AT2032/2025torikon/README.md

# 2025鳥コンの電装資料
## 組み立て
### 琵琶湖に行く前
- コクピに取り付け済みの部品
  - [コクピ事前準備(トラック積み込み前).md](https://github.com/AT2032/2025torikon/blob/main/%E3%82%B3%E3%82%AF%E3%83%94%E4%BA%8B%E5%89%8D%E6%BA%96%E5%82%99(%E3%83%88%E3%83%A9%E3%83%83%E3%82%AF%E7%A9%8D%E3%81%BF%E8%BE%BC%E3%81%BF%E5%89%8D).md#%E3%82%B3%E3%82%AF%E3%83%94%E4%BA%8B%E5%89%8D%E6%BA%96%E5%82%99)
- 他の準備
 - トランシーバー充電
 - リポ充電
### 琵琶湖ついてから
- 電装の検品・バッテリー準備
