AT2032/2025torikon/25代電装全体図.md

# 基本設計
## 全体像


## 物理的な配置
