AT2032/2025torikon/準備＆組み立て手順.md

# 琵琶湖に行く前
## コクピに取り付け済みの部品
  - [コクピ事前準備(トラック積み込み前)](https://github.com/AT2032/2025torikon/blob/main/%E3%82%B3%E3%82%AF%E3%83%94%E4%BA%8B%E5%89%8D%E6%BA%96%E5%82%99(%E3%83%88%E3%83%A9%E3%83%83%E3%82%AF%E7%A9%8D%E3%81%BF%E8%BE%BC%E3%81%BF%E5%89%8D).md#%E3%82%B3%E3%82%AF%E3%83%94%E4%BA%8B%E5%89%8D%E6%BA%96%E5%82%99)
##  他の準備
 - トランシーバー充電
 - [動作確認](https://github.com/AT2032/2025torikon/blob/main/%E5%8B%95%E4%BD%9C%E7%A2%BA%E8%AA%8D.md)
 - リポ充電
 - 電装BOXと持ち物(個人で持っていくものの確認)  
[電装持ち物リスト](https://tusedu-my.sharepoint.com/:x:/g/personal/8223036_ed_tus_ac_jp/EaBhuFKCY5RGtiFWbql846QBNDzBeOHudqavIxN8KoX_pQ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)
# 琵琶湖ついてから
## 電装の検品・バッテリー準備
- ゆるみの確認
 - メイン電装の固定ネジ確認
 - アンテナのゆるみ確認
 - メインSD
- ピトー管のベーン取り付け
- バッテリー搭載
  - バッテリーの電圧をテスター測定し，12.5V以上であることを確認する
  - バッテリーのコネクタを接続し，タッパーに入れる

組み立て手順(コクピ班のもの)


## ピトー管接合
- フレームとT字を接合したい状態でピトー管をフレームにつける(位置はフレームにマステを貼ってある)


- ピトー管をつけた後は安全保護用に発泡を下につける(白養生で止める)


## 電装基盤の取り付け
- かまぼこをフレームに取り付け，その後電装基盤の板を入れる
- 基盤を入れたらケーブルのコネクタを取り付ける


- [動作確認](https://github.com/AT2032/2025torikon/blob/main/%E5%8B%95%E4%BD%9C%E7%A2%BA%E8%AA%8D.md)
(超音波とピトー管，サーボを取り付けて正常に動作するかを確認する)

## サーボのケーブル
- カウルを取り付けた後に，カウルの穴にケーブルを差し込んでカウルの中にケーブルを入れる(ケーブルは白養生で固定する)



- カウル内部のケーブルはT字やカウルに養生テープで固定する



## 機体下電装
- カウルをつける前にカウルに機体下電装の基盤とケーブルを養生テープで固定する(固定する際，超音波センサーができる限り地面と水平と平行になるように固定する)

- カウルをつける際に，ケーブルの接続とテグスをフレームにつける

## ピトー管先端取り付け
- 上2のカウルが取り付け終わった段階でピトー管の先端のケーブルを接続し，取り付ける


## 電装安全確認
- 操縦桿周りの安全確認
- ピトー管の固定具周りの安全確認
- スピーカーの安全確認
- ケーブルの安全確認(ケーブルがぶらーんとしてなければOK)

## AoAとAoSの定常状態の確認
- カウルとキャノピーを取り付けた後で電源を入れ，AoAとAoSの定常状態を確認する(水平は目視で揃える)
