AT2032/2025torikon/プラホ.md

# プラホ上での電装の仕事(けんの＋くり)
# 持ち物(絶対に忘れない)
- テレメトリ
- テレメトリ用CtoC
- アンドロイドスマホ(充電がなければ他の人のを借りる)
- ピトー管フィレット前後1個ずつ
- カッター
- クリアテープ
## 役割(けんの)
- テレメトリでの各種動作確認
- 操縦桿と垂直の動きを見る(ニュートラル確認＋左右の垂直の動き(くらのすけが操作))
  - ニュートラル調整後にニュートラルの値を確認してスマホに記録する(スクショでもいい)
  
## 役割(くり) → プラホあがるときにピトー管のフィレットを持っていく
- ピトー管フィレットをつける(水町さん+くり) → 左右のフィレットのつなぎ目の部分をクリテで止める


- メインの電源を入れる
  - メインの電源を入れた段階でストップウォッチをスタートし，TAKEOFFの時点でラップをつけ，着水時にストップウォッチを止める(ログの解析のため)
  
    
- 垂直のニュートラル位置調整
- メインのLEDがすべてついているか確認
- ピトー管カバー取り外し
## スケージュール
  

## 抜けるタイミング
- 同じタイミングで抜ける(ラダーの左右の動きを見てから)
- けんのからテレメトリを受け取る
