AT2032/2025torikon/エアデータ製作/ハードウェア/回路・基板製作/回路・基板設計.md

## 回路設計(回路図ファイルはこちら)
<p align="center">
　
  <em>エアデータ回路図</em>
  <br>
</p>

- SD書き込み関しては時間がかかるため，一番通信速度の速いSPI通信([SDのピン配置](https://ht-deko.com/arduino/micro_sdcard.html))
  
- センサとマイコンはI2C通信
  
- マイコンとメインマイコンはUART
  - RRXT → Raspberry pi pico RX - XIAO RP2040 TX
    
  - RTXR → Raspberry pi pico TX - XIAO RP2040 RX
 
- センサとSDの電源入力はマイコンの3.3V出力のピンとつなげる

- マイコンには電源(外部)から5Vを供給する

- I2Cに関してはAS5600が2個使う+AS5600がI2Cアドレスの変更ができないため，チャンネルを2つ使う

- 今回はAS5600(AoA用)とpitotube(差圧センサ)にチャンネル1を使い，それ以外はチャンネル0を用いた  
  (AoAとAoSのセンサでチャンネルが分けられれば他はどのチャンネルに割り当てても変わらない)
  
<p align="center">
 
</p>

- XIAO RP2040のピン配置は上の画像(本来は[こっち](https://wiki.seeedstudio.com/ja/XIAO-RP2040/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)のピン配置が正しいがこのピン配置でも動作することが分かった)

  - 注意点はあるので[このサイト](https://tamanegi-digick.com/it/xiao2040rp/)を読んでおく

## 基板設計(基板図のファイルはこちら)
<p align="center">
 
  <em>エアデータPCB画像</em>
</p>

- 基盤の縦の長さはセンサを全て配置でき，センサの基盤が外に飛び出さない最小の長さにした。

- 基盤の左右にコネクタを配置
  - 片方は基板に配置できない差圧センサとの接続用(I2C)
    
  - もう片方はメイン基板との接続用(UART)
 
- 基盤の長さをできるだけ短くしたかったのでSDカードスロットに関しては基板の裏面に配置
  
  - 実装の際にはんだ付けできるようにSDカードスロットのピン配置と他のセンサの位置を重ならないように少しずらした

- 基盤には固定具取り付け用のねじ穴を計5個配置する

- AoAのセンサを基板に足して横向き(垂直方向)に取り付ける形状，基板の形は写真のようないびつな形になった。

<p align="center">
  
</p>

- もともとは上の写真(あざみ野)のようにエアデータセンサの基盤とAoAとAoSの基盤を分けて作るつもりだったが以下のような問題点があった
  - 基盤を分けて作るのはめんどくさい(部品が多くなるのは嫌だ)
 
  - パイプ内に基盤を固定する必要があり，固定するものが増えると固定具の作製の難易度が上昇する
 
  - 基盤をパイプに入れるとき，CFRPのパイプであるため基板を押し込む必要があり，この形状ではそれが厳しい(取り出したり，メンテナンスができない可能性がある)

- 平面の基板に垂直ピンや垂直取り付け台によってセンサを横向きに取り付けることできる

  - 上記の問題点を解消できる
 
- 基板設計を行いセンサの位置を決めた段階でパイプの形状や固定具の設計も決まる(後述)

## 基板実装
<p align="center">
  
  <br>
  <em>エアデータ基板3Dモデル(表面)</em>
</p>

<p align="center">
  
  <br>
  <em>エアデータ基板3Dモデル(裏面)</em>
</p>

- 基板のセンサ配置にセンサを配置し，はんだ付け

  - 基板の向きに気を付ける(特にBNO055)
 
  - SDカードスロットは裏側に取り付ける(最後に取り付け)
 
<p align="center">
  
  <br>
  <em>エアデータ基板完成図</em>
</p>
