AT2032/2025torikon/要件・全体要求.md

# 要求
要求は上から順に優先。フライトデータの取得よりも飛ぶことが優先
- システムの要求
  1. パイロットの操作でラダーを制御する
  2. プラットホーム上で姿勢の確認
  3. パイロットに速度と対地高度を伝達する
  4. フライトデータを取得する
- 電装班運営の要求
  - 必要な技術を継承する  
# 要件
- 信頼性
  - 故障した際に優先度が低いものが高いものに影響を与えない
    - 無線通信が混信しても他に影響を与えない
    - メイン電装のマイコンが停止しても操舵系は機能を維持する
    - SDカードが脱落しても他の機能は動作する
  - ソフトウェアのバグ，コクピフレームとの接触による短絡，通信線の切断などの故障を想定する
- 安全性
    - 着水時に発煙・発火しない
    - パイロットの頭部付近に電装を配置しない(配置する場合は安全対策をしっかり考える)
- 稼働時間
  - 着水までバッテリーが持つ(バッテリーに最後にアクセスできるタイミングを考えておく)
  - 電圧の監視が可能である
- 環境
  - 機体が直射日光にあたり温度が上昇しても動作する
  - 多少の水滴では故障せず動作し続ける
  - 直射日光下でLEDを見る必要がなく運用できる
  - トラックで輸送する場合，振動や熱に耐えられる
  - 機体の金属やCFRPの粉，琵琶湖の砂の対策がされている
- 運用
  - プラホ上での電装作業を最小限にする
- 開発環境・メンテナンス
  - 琵琶湖で機体を組んだ状態で電装のプログラムを変更できる
  - デバッグに必要な情報をなるべく多く出力する
