AT2032/2025torikon/あ.md

# 要件・要求定義
# 全体像
# エアデータ製作
## ハードウェア
### 回路基板設計
### ケーブル
### 外殻
### 内部固定具
### ベーン
## ソフトウェア
# ラダー制御脊索
## ハードウェア
### 回路基板設計
### ケーブル
### サーボ
## ソフトウェア
# 機体下電装製作
## ハードウェア
### 回路基板設計
### ケーブル
## ソフトウェア
# メイン電装製作
## ハードウェア
### 回路基板設計
### ケーブル
## ソフトウェア
# 班長業務
# 無線機製作
## ハードウェア
## ソフトウェア
# ログの見方(解析方法)
# 電装勉強法
# 鳥コンの動き
# 予算関係
