AT2032/2025torikon/25代製作資料.md

# 2025　電装班
(もっと早くに書いておくべきだった)  
書き方は23代のブログの構成のパクリ → [偉大な先輩のブログ(23代製作資料)](https://771-8bit.com/blog/birdman-glider-avionics/)
# 要求定義
要求は上から順に優先。フライトデータの取得よりも飛ぶことが優先
- システムの要求
  1. パイロットの操作でラダーを制御する
  2. プラットホーム上で姿勢の確認
  3. パイロットに速度と対地高度を伝達する
  4. フライトデータを取得する
- 電装班運営の要求
  1．必要な技術を継承する
# 要件定義
## 共通事項
### 非機能要件
- 信頼性
  - 故障による直接的な機能の喪失は認めるが，優先度が低いものの故障が高いものに影響を与えないような設計にする
    
    - 無線通信が混信しても他に影響を与えない
    - メイン電装のマイコンが停止しても操舵系は機能を維持する
    - SDカードが脱落しても他の機能は動作する
  - ソフトウェアのバグ，コクピフレームとの接触による短絡，通信線の切断などの故障を想定する
  - システムが複雑になるため基本的に冗長は組まず，予備部品の容易で対応する
- 安全性
  - 着水時に発煙・発火しない
  - パイロットの頭部付近(特にキャノピーより前)に電装を配置しない
- 稼働時間
  - 着水までバッテリーが持つ
    - 電圧の監視が可能である
    - バッテリーに最後にアクセスできるのは移動前(ハッチがある場合はこれ，ない場合はバッテリーに最後にアクセスできるのはフライト前日の機体組み立て開始時)
- 環境
  - 機体が直射日光にあたり温度が上昇しても動作する
  - 多少の水滴では故障せず動作し続ける
  - 直射日光下でLEDを見る必要がなく運用できる
  - トラックで輸送する場合，振動や熱に耐えられる
  - 機体の金属やCFRPの粉，琵琶湖の砂の対策がされている
- 運用
  - プラットフォーム上で電装の電源を起動できる
  - プラホ上での電装作業を最小限にする
- 開発環境・メンテナンス
  - 琵琶湖で機体を組んだ状態で電装のプログラムを変更できる
  - デバッグに必要な情報をなるべく多く出力する
- 拡張性
  -　とりあえずなし？
### 制約条件
- 電気的制約
  - SPIとI2Cは通信速度が速く，通信距離が短いため，基板内のみで使用
  - 基板間の通信はUARTでおこなう
  - マイコンの動作電圧は多くのセンサーに合わせて基本3.3V
- 技術的制約
  - Arduino IDEを使用し，自力でライブラリを書かなくてよい構成とする(できる限り)(ライブラリを作る場合は使い方を明記しておく)
  - CANはなるべく使用せず，UARTによる文字列送受信を行う
  - チップ部品は使用しない
  - ケーブルの圧着は基本せず，既製品を使用する
## 操舵
そもそもワイヤーリンケージかフライバイワイヤーかはチームにノウハウがあるかで決めていいと思う
鳥科では代々使われてノウハウがあるフライバイワイヤーを用いる

- パイロットの操作でラダーを制御する
  - 入力を読む
    - 去年まではジョイスティックを用いていたが，ジョイスティックではパイロットが体重移動しながらのラダー操作が難しい上に，直感的な操作がしにくいため，
    - アナログ入力を読むため，回転しやすい可変抵抗を取り付け，レバーの引き具合でラダーを制御できるようにする
    - 不感帯を含む，任意のカーブを設定できる
  - サーボモータを動かす
    - 十分なトルクがある
      - 風対策(逆電流防止)
    - 信号・電力の減衰が起きない
      - ケーブルが断線しない
      - ケーブルの電圧降下が小さい
      - テールまでの長いケーブルで問題なく信号伝達ができる
- その他の要件
  - トラブル時ニュートラルでフライトできる(これは機構側で担保 → ニュートラルロック)
  - プログラムを変更せずに琵琶湖でニュートラル調整が可能である(操舵範囲は事前調整)
  - テールを軽くする
    - バッテリーはコクピに搭載
    - 軽量なサーボを使用
  - 機体内通信を含む，無線通信で操舵を行ってはならない(大会ルール)
## テレメトリ
- プラホから発進時に姿勢などを確認できるようにする
  - 受信機はポケットに入る程度のサイズにする
    - PC・タブレットは大きくてプラットほーおむで扱いづらい(特に雨天時)
- デバッグのため，全センサーデータをダウンリンクする
## 高度速度計
パイロットからは高度や速度は分かりにくいため，測定したデータを何らかの手段を用いてパイロットに伝える必要がある
- パイロットに対地高度・対気速度を伝達する
  - 対地高度を推定する
    - 測定精度は0.1m単位を要求
    - 技術的な制約
      - 高高度では気圧高度を，低高度では超音波高度を信用すべき
        - 気圧高度は湖面からの絶対高度は分からない
        - 超音波は(ほとんどのセンサーで)高高度からでは届かない → 最近は最大測定距離が8mのものもあるけど，精度が怪しかったり，測定周期が遅かったりする
      - 気圧センサ
        - 動圧・ハッチの衝撃によるセンサーの外れ値を弾く
        - 中央値を取るために違う場所に3つの気圧センサを配置する
      - 超音波センサ
        - 水面付近は気圧高度より信用できる
  - 対気速度を測定する
    - 記録方法は後述
  - パイロットに情報を伝達する
    - 視覚は前方に集中するのでモニター等は使えない
    - 触角は操縦に影響するので使えない
    - 使えるのは聴覚のみ
  - その他の要件
    - フェールセーフ
      - センサーデータが取得できない場合，異常だと検知した場合は読み上げを行わない(ソフト側)
## ロガー
- 下記のデータを記録する

| 優先度 | 測定値 | 備考 |  
|---|---|---|
| 高 | GPS |  ある程度信頼できるため冗長の必要はない  |  
| 高 | 超音波高度 |  超音波が干渉するため1つだけ搭載する  |  
| 高 | 気圧高度 |  高度計の信頼性を確保できる分だけ搭載する  |  
| 高 | 対気速度 |  ピトー管を機体の気流に影響されない位置に取り付ける  |  
| 中 | ラダー操作量 |  ラダー操作に影響を与えないように  |  
| 中 | 9軸・姿勢 |  機体の向きとが正しく分かるようにぐらつかないしっかりした場所に載せる  |  
| 低 | AoA(Angle of Attack)・迎え角 |  ピッチ測定で十分だが，精度をこだわる場合は必要  |  
| 低 | AoS(Angle of Slip)・滑り角 |  代替手段がなく，AoAと同じく製作が高難度  |
- データを同期した状態で記録する
- 着水時にデータをロストしない
- 大型のかっくきで急速な動きをしないことを念頭に置いてデータレートを決定する
  - データレートは大体10~20Hz程度であれば大丈夫
  - 要求に完全に合わせるよりもマイコンのスペックで実現可能なものを実装する流れになるので定量的な要求は出さない
# スケジュール
- BBM：ブレッドボードモデル，試作
- EM：エンジニアモデル(プロトタイプ)
- FM：フライトモデル，本番用
# 基本設計
## 全体像


- UART通信速度  

  - エアデータ電装部，機体下電装部はSD書き込み以外のタスクもあるため460800bpsにした
  - メインマイコンはGPSからデータを受信するのみであり，TWELITEにデータを送信するだけなので，GPSとTWELITEで同じUARTポートを用いた(GPSはRX,TWELTEはTX)
  - メイン2層目へのSD書き込みのUARTは操舵角と同じUARTポートを用いた
  - メイン2層目へのスピーカー処理用のUARTはSD書き込みとは別のUARTチャンネルを用いた(データ量が多すぎるため，分けた)
  - GPSとTWELITEは9800bps，操舵角が115200bps，(GPSは460800bps,TWELITEは230400bpsまでいける)
  - 通信速度は速い方がデータの遅延なども少なくなるので早いに越したことはない
- 各コンポーネントの必要性
  - 機体下：超音波センサを機体下部に搭載する必要(高度測定のため)
  - エアデータ：ピトー管を機体外部に搭載する必要(機速測定のため)
  - 操縦桿：パイロットの近くに配置する必要(ラダー制御のため)
  - 電源部：防水が必要な区画を最小限にするため独立
  - スピーカー：聞きやすい位置に配置するために独立
  - ラダー：垂直尾翼の機構にサーボのみ配置(テール側の重量を最小限にするため)
  - 無線ハブ：無線が通じる部分であればどこでも可(CFRPは電磁波を遮断するため，桁内部などはなし)
  - メイン：独立
- メインマイコンはRaspberry Pi Pico
  - UARTがたくさん欲しい(ボードマネージャーを[特定のもの](https://logikara.blog/raspi-pico-arduinoide/)にすれば，ハードでのUARTピン以外にソフトでUARTのピンを指定することが可能)
  - Arduino IDEを用いてプログラムできる
  - コンパクト
  - 24代である程度使い慣れていた
- 他のマイコンは小さいのでSeeed Studio XIAO RP2040
- ラダーのサーボモーターは鳥科で代々使っている近藤科学の[KRS-4034HV ICS](https://kondo-robot.com/product/krs-4034hv-ics)
  - トルクについて定量的な要求を出すのは難しいが，前年これで不足はなかった
  - テールヘビーを避けるため軽量なものが良い
  - （まず無いけど）水平尾翼を電装制御したくなった場合でも，複数のサーボをデイジーチェーン接続できるので電装の設計変更が少ない
- 操縦桿の制御マイコンはケーブルの配線上，独立させることができな為，メイン基板に載せたが，メインのセンサと配線を繋げたりはしない
  - 操舵系はクリティカルなため余計な機能を混ぜない
- エアデータ電装部は有線接続(電源通信両方)
  - パイロットにリアルタイムで対気速度を繋げたい
  - 他と同期してデータを取りたい
- TWELITEは一度に処理できるデータの量と処理時間が遅い
  - 送るデータを何個かに分けて送る
  - プログラム上でメインマイコンでのセンサの測定周期と独立させる(今回はマルチコアを用いた)
  - 電装班の技術力的に通信は有線の方が安心(Bluetooth/WiFiはムズイ)
  - 電源は独立でも良いが，通信は有線なのでまとめて有線
- 電源設計
  - サーボモータ用に3セルのLiPoバッテリーを搭載
  - 火災防止のためサーボに過電流保護を挟んで供給
  - 電源はサーボ用のLiPoバッテリーのみで，ロガー系もこれから供給する
    - ロガー系からの故障リスクよりも，電源を分散させる手間の方が大きいと判断
    - 高く計測のための操舵系の信号線がロガー系に繋がっているため，電源を完全に分離してまで故障を防ぐのは意味がない
    - 電源を分散させると，各機器の起動タイミングによるもんだん・各バッテリーの残量管理の手間・電源投入の手間が増える
- 姿勢センサの受信側のデバイスはスマホのシリアルモニタ
  -　液晶などを使うのはだるい
  - スマホアプリの開発は面倒だが，シリアルモニタならアプリがあるため，マイコンとつなげるだけで複雑なことがいらず楽
## 物理的な配置
- 写真載せる
- 操縦桿はパイロットが操作しやすい位置
  - 操縦桿は重心移動しながらの操作を可能にするため，パイロットが握るフレームの位置に取り付け
- 機体下電装部は超音波センサを湖面に垂直に向けることができれば場所は任意(できるだけ機体の最下部の部分につくようには意識)
- スピーカー部は場所は任意(音が聞こえるならどこでも可)
- エアデータ電装部はコクピ上
  - 去年までは左翼に配置していたが，今年はAoA,AoSをとりつけるのと電装をコクピ近くで完結させるためにコクピ上に置くことにした。
  - コクピの上からCFRPのパイプを用いて角を生やした
## 質量概算
- 資料なかった…　ごめん
- 毎年，機体のコンセプトによって軽めにするか，重めにするかが変わるため，製作の際は設計の人と確認しながら電装の重量を減らしたりする(増やす場合は電装でなくても錘つけるといった対応ができるため，必ずしも電装が重量を増やす必要はないかも…)
- 重量を減らすために電装部品を減らす場合は電装部品をもっとコンパクトにできないか(センサーを変える，基板を小さくする，材料を軽いものにするなど)を考える。それでもダメな場合は電装の代用が効く部品を減らす。
- 重心の位置によっては場所が変わる場合もあることに注意(今回はメインとかエアデータの部分が全組の重測で変わった)
# 詳細設計・製作
電装は作ってみないと設計が固まらないので詳細設計と製作はほぼ同じ

とにかく要求を満たすものを作れれば良いので，手を動かしていろいろ試しつつ，設計の根拠はしっかり記録に残す
## 全体
### UARTフォーマット
桁が固定されていない少数をカンマ区切りで送信し，改行コード(\n)をつける。通信速度は送受信以外のタスクもあるため460800bpsとした。

機体下電装部->メイン電装部  
`気圧[hPa],温度[deg],気圧高度[m],超音波高度[m]`

エアデータ電装部->メイン電装部  
`気圧[hPa],温度[deg],気圧高度[m],差圧[Pa],対気速度[m/ss],AoA[deg],AoS[deg],加速度(x軸)，加速度(y軸),加速度(z軸),クォータニオン(w),クォータニオン(x),クォータニオン(y),クォータニオン(z),ロール,ピッチ,ヨー`(多すぎる)

メインマイコンからは，SD用マイコン・機体下電装部・エアデータ電装部のmicro SDに保存する文字列を直接送信する。  
SD用マイコンはデータを受信するだけで，舵角計測でRXを使っているUARTポートのTXを使うので115200bps
  
### コネクタ・ケーブル
- すべて手で圧着はせず，コネクタ付きのケーブルやアッセンブリワイヤーなどを使用する
- ケーブル同士やケーブルとアッセンブリワイヤーを接続する場合は芯線にフラックスを塗り，その上からはんだを載せて接続する。接続したらはんだをむき出しにするのではなく，熱収縮チューブを用いて表面を保護する
- [ケーブルのはんだ付け参考資料](https://www.diylabo.jp/basic/basic-39.html)
- コネクタ選定
  - 汎用：JST-XHコネクタ
    - 2,3,4,5ピンの在庫がある
    - [XHアッセンブリワイヤー](https://www.daisen-netstore.com/shopdetail/000000000152/)
  - 中継：JST-SMコネクタ
    - 中継用ならこれ
    - TORICA-UARTの中継
      - [SMケーブル](https://www.amazon.co.jp/BTF-LIGHTING-JST%E3%82%B3%E3%83%8D%E3%82%AF%E3%82%BF%E3%83%BC-15cm%E3%83%AF%E3%82%A4%E3%83%A4%E3%82%B1%E3%83%BC%E3%83%96%E3%83%AB%E3%82%A2%E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)
        - 最大電流３Aで，他のいい感じの中継コネクタもないからこれで
- サーボの差し込み部分のコネクタ
  - サーボ専用の端子はアッセンブリワイヤーがないため使わない
  - [サーボに付属する専用のケーブル](https://kondo-robot.com/product/krs-4034hv-ics)を切ってはんだ付けして接続する
- ピン配置
　短絡などの事故を防ぐため，電源とGNDは常に同じ位置に配置する
  - 今年は赤が電源，黒がGNDになるようにした。
  - 今年の色(時間があれば書く)
- ケーブル
  - シールドの扱い
    - 全て静電シールドなので，電源に近い方側で電源に近い方側でシールドをGNDに接続する
    - サーボケーブルも近くに他の信号線はないので，ノイズを漏らさない電磁シールドケーブルではなく周囲からのノイズを防ぐ静電シールドケーブル
  - サーボ・電源用ケーブル
    - [FA用300V電源・低速移動屈曲配線ケーブルシールド有](https://www.monotaro.com/p/3496/7344/)
      - 3芯・シールドあり・AWG22(QIコネクタ,2550コネクタの最大)・3m以上
