AT2032/2025torikon/トラブルシューティングマニュアル.md

# トラブルシューティングマニュアル
## テレメトリ受信不具合
- 受信機側の不具合
  - 受信機内のマイコン委電源が供給されているかの確認
  - ボーレート，COMポートの確認
  - 表示機-受信機が間のケーブルの交換
  - 受信機側が壊れていたら替えがないため，ダウンリンクはメインのLEDで確認する(最悪の手段)
- 送信側の不具合
  - 1層目―2層目のケーブルを確認
  - メイン電装2層目を予備に交換
  - TWELITEを予備に交換
 
## メイン電装に電源が供給されていない
- 電流電圧計に値が表示されていない
  - ヒューズが熱くなっていればどこかで短絡している
  - そうでなければリポ-基板間のケーブルが切断or接触不良
  - いずれにしてもテスターを使いながら調査する
- 電流電圧計に値が表示されている
  - 基盤に繋がるケーブルの不良を疑い，テスターを使いながら調査
  - 基盤(ICS変換基板)の故障の可能性あり → 予備に交換
- 電源系が故障しているときに容易に基盤を交換するのは危険
  - 予備基板も含めて故障する可能性がある
  - できるだけ原因を特定してから

## メイン電装の測定値がおかしい
- GPSのみがおかしい
  - ロックされていないだけの可能性が高い
  - 1層目―2層目のケーブルを一応確認
- 気圧センサ・姿勢センサがおかしい
  - 予備基板に変える以外対処法なし
  - 気圧センサがおかしい場合推定高度に影響が出るためソフトの偏光が必要
  - あきらめも肝心
## エアデータ，機体下の測定値がおかしい
- 基盤を確認し，マイコンが点滅or点灯しているか確認する
  - 点滅or点灯していない場合，ケーブル不具合
  - テスターでどこのケーブルがおかしいか特定し，交換できるなら予備に交換する
- 点滅/点灯はしている場合，基本は予備基板に交換するしかない
  - 差圧センサのみの交換なども試し，ダメであれば予備基板に交換する
  - 治らなかったらどんまい
## スピーカーの音が鳴らない
- テスターで電圧がかかっている場合
  - スピーカーの不具合なので，予備に交換する
  - それでもダメであればあきらめる
- 電圧がかかっていない場合
  - ソフトのミスor基板の不具合なのであきらめる
## サーボが動かない
- テレメトリのAngleに0以外の値が表示されていない
  - ICSデータ遮断トグルスイッチが倒されていないか確認
  - 操縦桿側のトラブル
    - 操縦桿のケーブルが断線している場合は取り換える
    - 操縦桿の基盤がおかしい場合は取り換える(湖岸ではできるだけやりたくない，トラック積み込みの前に動作確認は絶対に行う)
- 0でない値が表示される
  - ICS変換基板以降のトラブル
    - サーボのケーブルを確認
    - メイン電装の交換を検討
- 解決できなかった場合，ニュートラルロックを接合に依頼
## 推定高度
- 超音波センサ高度
- メイン気圧高度
- エア気圧高度
- 機体下気圧高度
の4種類を使って機体の高度を推定している。そのため，正しい高度を出さないセンサがあると，推定高度がずれる可能性がある
ソフトウェアで補正する用にはしているが，無用なトラブルを避けるため，あらかじめ動作しないことが分かっているのであれば，プログラムをその使用に書き換える
# 対処実施判断(コクピ組み立て前)
- センサ・スピーカー計
  - 操舵系に影響を与えない対処はすべて実施
- 操舵系
  - 全ての対処を実施(テール桁のケーブルの交換は接合と相談，できるだけ断線させないように常に見張っておく)
  - センサ系・スピーカー系が動作しなくなるとしてもこちらを優先させる
  - 前日の時点でニュートラルロックはできる限りしない
# 最終判断(コクピ組み立て後)
- センサ系・スピーカー系
  - 機体を解体しないと対処できない問題は対処しない
  - 操舵系に少しでも影響を与えそうな問題も対処しない
  - ソフトの書き換えは基本行わないが，推定高度計算部を書き換える必要があるときのみ，作成したプログラムを書き込む(最終判断は班長)
  - 最終リミットは桟橋直前
- 操舵系
  - 機体を解体しないと対処できない問題は対処しない
  - サーボのパラメータ書き込みは，サーボが全く動作しないときを除き実行しない
  - 最終リミットは桟橋直前，この時点で動いていないようならニュートラルロックを接合に依頼
