AT2032/2025torikon/運用・桟橋.md

# 持ち物(絶対に忘れない)
- テレメトリ
- テレメトリ用CtoC
- アンドロイドスマホ(充電がなければ他の人のを借りる)
- ピトー管フィレット前後1個ずつ
- カッター
- クリアテープ

# 湖岸運用・桟橋でのスケジュール


## やること(運用中)
- サーボは単体で持っておく(断熱袋に入れて，冷却する場合はタオルでサーボを包み，結露しないようにする)
- テレメトリでダウンリンクを見てそれぞれの値がしっかりとれていることを確認する(ICS以外)
- GPSを確認し，GPSのLEDが点滅するまで待つ
- GPSが測位完了したら電源をOFFにする
- 運用のローテの交代途中でスピーカーの動作確認もできるのなら確認する

## やること(桟橋)
- サーボを桁に入れ，固定する
- サーボを固定した状態で電源を入れ，サーボが動作するかを確認する
- サーボが動かない場合は変えのサーボと交換する
- サーボがちゃんと動いたら電源をOFFにする
- どのサーボも動かない場合はニュートラルロックを行う
