AT2032/2025torikon/動作確認(組み立て中).md

## 事前準備
- エアデータベーン取り付け
  - センサが入っているパイプを取り出し，ベーンと，SD,マイコンカバーを取り付ける
## 仮接続(ピトー管がフレームに固定され，機体下もカウルにつけて基盤と接続するまで)
  - 動作確認用の４Pケーブル(SM4Pin-XH4Pin)を使用してピトー管のパイプから出ているコネクタ(SMコネクタ)と接続する
  - 操縦桿のケーブルをメインと接続する
  - スピーカーのケーブルをメインと接続する
  - メインと機体下電装フレーム中継ケーブルを接続し，機体下電装カウル中継ケーブルと接続する
  - 予備のサーボモータと接続する
## 動作確認
 - テレメトリ受信機をスマホに接続し，シリアルモニタで通信を開始する
 - メイン電装部の電源スイッチをONにする
 - 超音波センサを手で遮り，スピーカーが鳴ることを確認する(マイコンが起動してから15秒後)
 - 起動直後のダウリンクデータが取得できていることを確認する
 - 超音波センサから地面までの距離を変化させ，超音波高度が変化し，スピーカーのなる周期が短くなることを確認する
 - ピトー管に息を吹き込み，対気速度とスピーカーの音が変化していることを確認する
 - AoA,AoSを回転させて値が取れているか確認する(時間があれば，定常位置も調べ，スマホに書いておく)
 - 操縦桿(ばねが張ってなくてもいい)を動かし，サーボモータが適切に動作することを確認する
## 取り外し
- 電源スイッチをOFFにする
- 動作確認用エアデータケーブルを取り外す
- ピトー管カバーをつける
- 機体下電装部カウル中継ケーブル，機体下電装部を取り外す
- 予備のサーボモータを取り外す
