AT2032/2025torikon/エアデータ製作/ハードウェア/エアデータ外殻製作/外殻設計.md

## 要件
- センサを機体から適切な位置に配置するためのマウント形状を設計・製作する必要がある。
  - 本年度はカウル上にセンサを設置し、電装系をコクピット内で完結させる構成とする。
 
  - エアデータセンサ（ピトー管、AoA、AoSなど）の特性上、センサ部を機体外に露出させる必要がある。
 
- 機体の外にセンサを置くため，センサの基盤を保護する用のカバ―も必要(部品選定の部分でも行ったがCFRPのパイプを用いる)

  - カバーの用途以外にAoA,AoSを取り付ける用にカバーを加工する必要がある(穴あけ)

- 安全性：飛行中にセンサやマウントが脱落しない十分な強度と固定方法を確保する。

- 運用性・保守性：整備やセンサ交換を容易にするため、着脱可能な構造とする。

- その他：機体の飛行性を低下させないための工夫を行う (機体の外に出る形状のため)

  ## あざみ野形状分析
- あざみ野もカウル上にエアデータセンサを配置しているため，あざみ野の形状を基に設計(参考資料:[あざみ野2022](https://drive.google.com/file/d/1DZ3CgDTqsoo9FFDT6lihETxIvnxeYHhx/view))

  <p align="center">
    
    <br>
    <em>図1　あざみ野のエアデータセンサ</em>
  </p>  

- 写真上で囲っている部分の形状は以下の写真のようになっている
- 整流性の向上のためにこの形状を用いている

  <p align="center">
    
    <br>
    <em>図2　エアデータセンサのマウント部分</em>
  </p>

- あざみ野ではT字桁に斜めにマウントのパイプを取り付けていた
 
  <p align="center">
    
    <br>
    <em>図3　マウントT字接合部</em>
  </p>

- センサーを載せた基板はGFのパイプで囲っている (基板に載せているGPSの電波を通すため，CFではなくGF)

- 先端部分(ピトー管部)はCFRPのパイプで自作している

  <p align="center">
    
    <br>
    <em>図3　ピトー管部分</em>
  </p>

# 設計
- 安全性の観点からマウントの部分はあざみ野と同じくCFRPのパイプを用いて作製

- センサーを載せるパイプの部分は

- それぞれのパイプを積層することで形状を作製
