AT2032/2025torikon/エアデータ製作/ハードウェア/回路・基板製作/Airdata_25th/Airdata.kicad_sch

## KiCad design エアデータ製作/ハードウェア/回路・基板製作/Airdata_25th/Airdata.kicad_sch (2025-10-26)

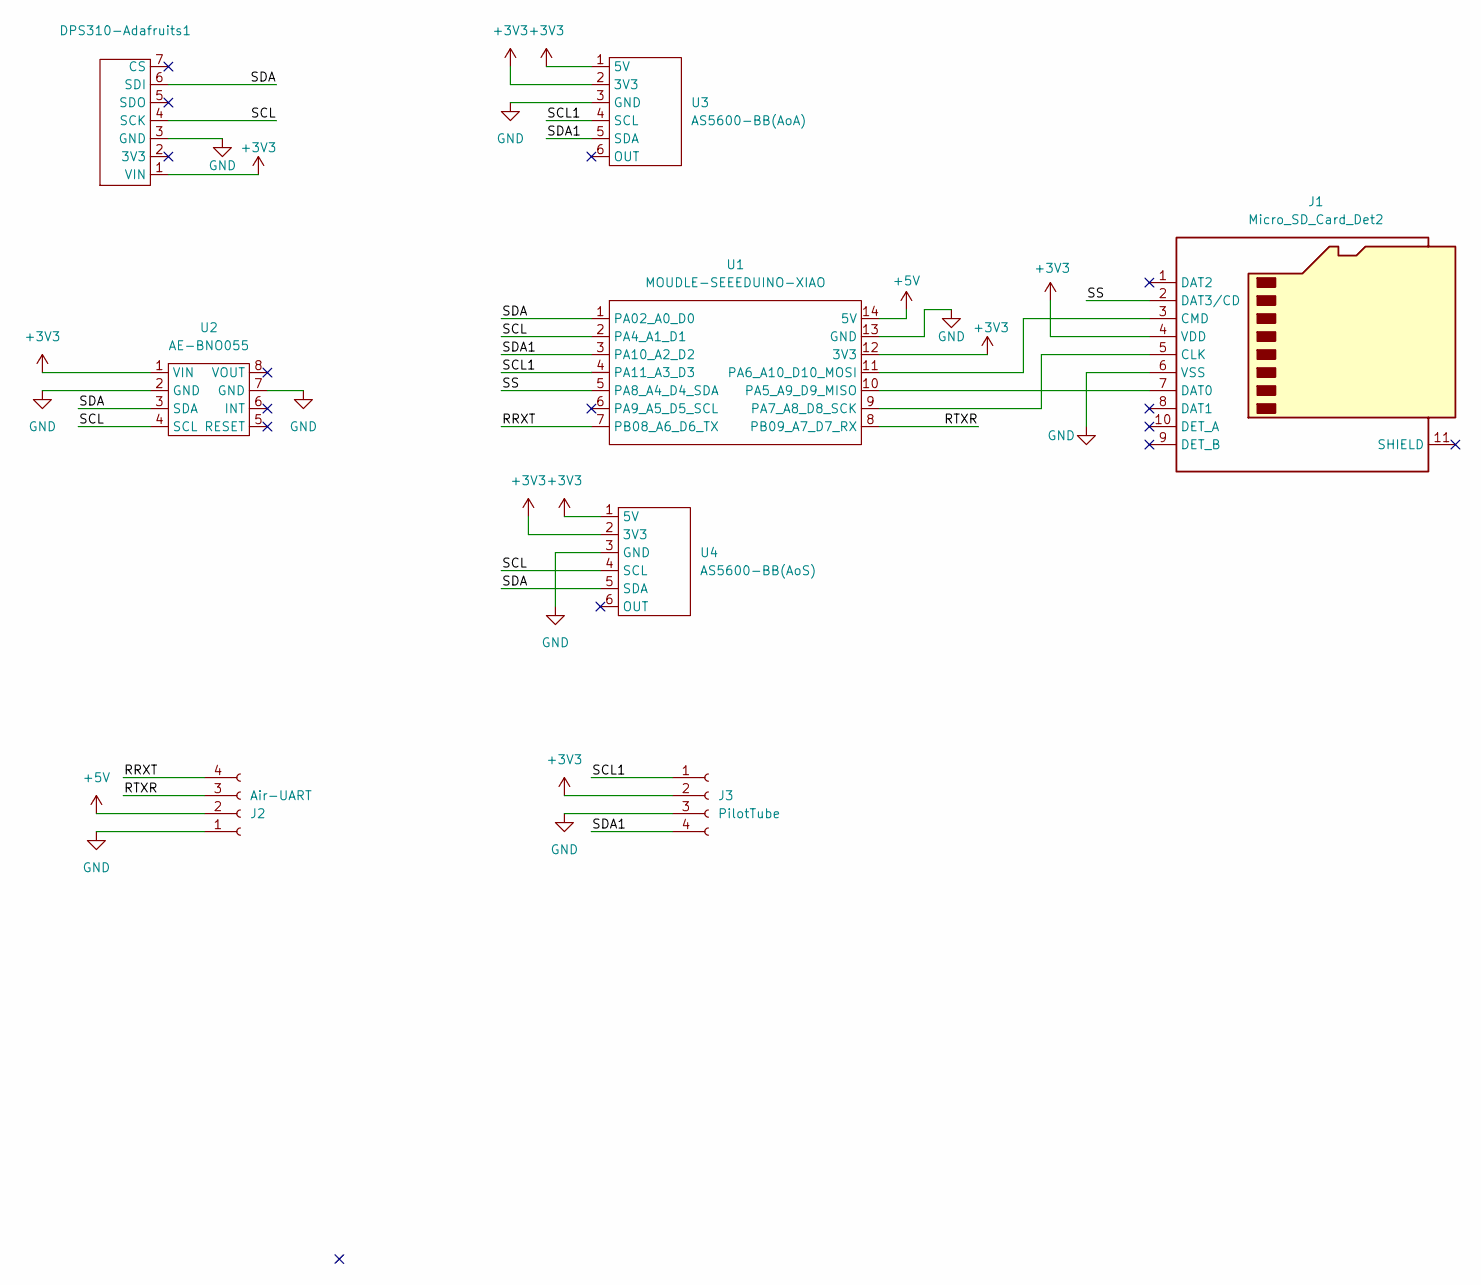
[picture p1: schematic Airdata.kicad_sch]

Parts:
DPS310-Adafruits1: DPS310-Adafruits
J1: Micro_SD_Card_Det2; microSD_AE-MICRO-SD-DIP
J2: Air-UART; JST_XH_S4B-XH-A_1x04_P2.50mm_Horizontal
J3: PilotTube; JST_XH_S4B-XH-A_1x04_P2.50mm_Horizontal
U1: MOUDLE-SEEEDUINO-XIAO; Seeeduino XIAO-MOUDLE14P-2.54-21X17.8MM
U2: AE-BNO055
U3: AS5600-BB(AoA); AS5600(vertical)
U4: AS5600-BB(AoS); AS5600BB_THT

Connections:
+3V3: DPS310-Adafruits1.1 (VIN), J1.4 (VDD), J3.2, U1.12 (3V3), U2.1 (VIN), U3.1 (5V), U3.2 (3V3), U4.1 (5V), U4.2 (3V3)
+5V: J2.2, U1.14 (5V)
GND: DPS310-Adafruits1.3 (GND), J1.6 (VSS), J2.1, J3.3, U1.13 (GND), U2.2 (GND), U2.7 (GND), U3.3 (GND), U4.3 (GND)
unnamed: J1.3 (CMD), U1.11 (PA6_A10_D10_MOSI)
unnamed: J1.5 (CLK), U1.9 (PA7_A8_D8_SCK)
unnamed: J1.7 (DAT0), U1.10 (PA5_A9_D9_MISO)
RRXT: J2.4, U1.7 (PB08_A6_D6_TX)
RTXR: J2.3, U1.8 (PB09_A7_D7_RX)
SCL: DPS310-Adafruits1.4 (SCK), U1.2 (PA4_A1_D1), U2.4 (SCL), U4.4 (SCL)
SCL1: J3.1, U1.4 (PA11_A3_D3), U3.4 (SCL)
SDA: DPS310-Adafruits1.6 (SDI), U1.1 (PA02_A0_D0), U2.3 (SDA), U4.5 (SDA)
SDA1: J3.4, U1.3 (PA10_A2_D2), U3.5 (SDA)
SS: J1.2 (DAT3/CD), U1.5 (PA8_A4_D4_SDA)
