AT2032/2025torikon/(commit log)

2025-07-17 組み立て手順.md
2025-07-19 Update and rename スピーカー配置場所.jpg to スピーカー配置場所.JPG
2025-10-25 Create 要件・要求
2025-10-26 Create エアデータ製作
2025-10-26 Create ハードウェア
2025-10-26 Update and rename 要求.md to 部品選定.md
2025-10-26 Update and rename 回路設計.md to 回路・基板設計.md
2025-10-26 Add overview image to circuit design documentation
2025-10-27 Update section titles for circuit and PCB design
2025-11-08 Update 2025年度 鳥人間サークル電装班 製作資料.md
